MailBirdAU/MailBird/docs/Scope Captures/Begin(58) Write(36) End().jpg

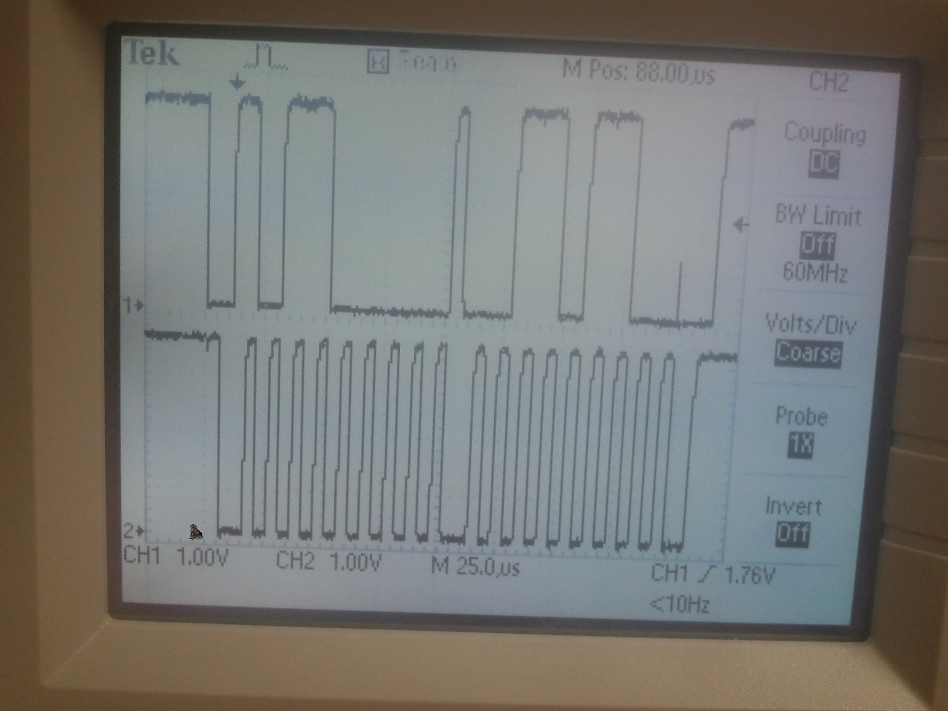
docs/Scope Captures/Begin(58) Write(36) End().jpg
