MailBirdAU/MailBird/README.md

MailBird
========

An Auburn University EE Senior Design Project
