MailBirdAU/MailBird/docs/Proposal/Proposal Presentation.pptx

Hugh Dillon, Zac Hawkins, Rick Holloway, Ben Smith, Hunter Thorington

MailBird

## OVERVIEW

- Mail Delivery Drone
- GPS – General Location
- Guidance Module – Precise Location
- Infrared LED Landing Pad

## Design Standards

- GPS Protocol
- RC Frequency – 2.4 GHz (Manual Flight Control)
- Flight Standards
  - Less than 4.4 pounds
  - Less than 400 feet above ground
  - Daylight conditions
  - 5 miles away from airports

## Constraints

- Economic Feasibility
  - Low cost quadcopter
  - Long battery life
- Manufacturability
  - Quadcopter
  - Guidance module

## Constraints

- Public Health and Safety
  - Max altitude
  - Avoid congested areas
- Privacy
  - No video camera

## Management Approach

- Decisions made by consensus in planning meetings
- Activities tracked on GitHub (https://github.com/MailBirdAU/MailBird)
- Communication via Github and GroupMe
- Meetings 2-3 hours per day, 4 days/week
- Minutes recorded by team leader

## Facilities

- Lab 368 – Design Lab
- Labs 308 and 310 – Computer Labs
- Outdoor Testing

## Budget

- Total budget of $50 per team member
- Estimated costs: ~$180
- Unexpected costs: ~$70

## timeline

- Proposal: January 22
- Cycle 1: March 6
  - Product prototype by end of February
- Cycle 2: April 25
  - Final design report by April 18
  - Senior Design Fair: April 25
