MailBirdAU/MailBird/docs/Proposal/Proposal.docx

Hugh Dillon | Zac Hawkins | Rick Holloway | Ben Smith | Hunter Thorington

# MAILBIRD

PROPOSAL FOR AN AUTONOMOUS DELIVERY SYSTEM

Wednesday | January 22, 2014

# 1 Project Description

## Abstract

This document details the preliminary approach to an autonomous package delivery system. A summary is given of the design specifications, and of the system that will be created to satisfy those conditions. Consideration is given to design decisions, technical specifics for implementation, and the anticipated use of the completed system. In addition, procedures are defined for project management, financial operations, and distribution of equipment after project completion.

## Executive summary

MailBird is a proof-of-concept automated mail system. A successful guidance system will use GPS to bring a quadcopter within five feet of the desired landing area. Subsequent to GPS localization, it will use a custom built guidance module to dock within a tolerance of 1 inch. The technical aspect of the project will be designing an aircraft guidance module and associated ground station (if necessary) to land in a precise location carrying a deliverable. This will be accomplished with a quadcopter equipped with an augmented precision external landing module (APELM), for extreme accuracy. The APELM will be designed to use infrared optics and LEDs to determine position. This module will interface with the flight controller to guide the docking procedure. After creating an effective, precision landing system, if time allows the system will be extended to include a software suite and mail delivery peripherals. The final result will be a comprehensive autonomous delivery system supported by a suite of a custom-designed scheduling, pick-up and delivery software.

## Project Definition

The MailBird project arose out of an Auburn University electrical engineering senior design section. After discussing numerous ideas, the design team decided that a satisfying project would involve a quadcopter. The intention was to use the unique flight capabilities of a quadcopter to accomplish a common task from both a literally and figuratively different perspective. Brainstorming with this constraint resulted in a large amount of ideas. One potential application placed a security camera in a difficult to reach area, such as the roof or exterior of a building. Another idea gave the quadcopter the ability to determine its surroundings and avoid obstacles while traversing from one location to another. Ultimately, elements of each idea were combined into a system that could carry an object and determine the location of a landing station in an environment. A parcel delivery system was the realization of the final idea; it would accomplish a common task from a different perspective, and it involved locating a delivery location for the parcel it would be carrying.

# 2 Technical Approach

## Design Considerations

We considered four options for transporting a package from one location to another via the quadcopter. The first option was solely using GPS to deliver the package to a predetermined location. However, the GPS location varies within a five foot radius. Since the required tolerance is within an inch of the desired landing area, GPS only will not suffice. The following three options all use GPS to bring the package within a five foot radius and use the custom guidance module to land.

The following three options were considered to precisely land the quadcopter: a camera to locate infrared LEDs on the ground, an optical camera to locate a red square on the ground, or an ultrasonic device to detect the frequency of the reception of sound waves. The following Pugh chart compares the three options.

Table 1 – Landing Implementation Comparison

The Pugh chart above is weighted to emphasize fulfilling the goals and enabling reproduction of Mailbird. All of the above options are complex in design and precise when it comes to landing so there is no differentiation in these two categories. Because of the affordability and reliability of the infrared camera and LEDs the net score is higher for option 1 (IR LED), which is the design chosen for mailbird.

Another design consideration that was analyzed by Pugh charts was whether to fly from dock to delivery location on a predetermined path or by going to the location with collision avoidance implemented on the quadcopter.

Table 2 – Guidance Implementation Comparison

The Pugh chart above is weighted according to the difficulty of the two choices and in order to not break any regulations already established by the FAA. Although collision avoidance in theory sounds good the practicality and difficulty of it compared to a predetermined route makes it a bad option.

The last Pugh Chart is shown to demonstrate why the design chosen is for general quadcopters and not just specific to the quadcopter used in MailBird. With a ratio of quadcopter size to landing pad size the design will hopefully be able to be implemented on any ArduCopter device.

Table 3 – Compatibility Comparison

## Potential Problems

The following is a list of potential problems we could run into with implementing the IR camera and predetermined path onto the MailBird:

### Coding limitations

Our group as a whole is not familiar yet with Arduino programming and how to respond to the infrared camera on the ArduCopter.

### Infrared White-out

How will the sun affect the IR camera? Will the sun reflect off the ground and cause the camera to see nothing but IR light? If this is the case, one alternative we have considered is building a focal point made out of PVC pipe painted black to block out some of the other light shining into the camera.

### Carrying Capacity

What is the maximum size package that the Arduino can carry? What is the ratio of increased package weight to battery life? How much power is the camera circuit going to take from the battery?

### New Buildings

When construction is going on the MailBird will continually have to be reprogrammed due to changes in geography and obstacles like cranes.

### Landing Module

How much is it going to cost each customer to buy/build the landing zone?

## Market Constraints

The MailBird system is intended to deliver small packages from a central hub to predetermined mail-drop locations. The idea is directed towards a market that requires frequent or scheduled delivery of packages with essentially immediate delivery. Market attributes including economic feasibility, manufacturability, public health and safety, social opinion, environmental impact, and political implications were taken into consideration when designing the MailBird system.

In order for the project to be marketable at all it must first and foremost be designed with the idea of profitability. With an low investment cost for the entire system and even less when equipping the tracking module to an already built Arduino based delivery system the MailBird is easily and cheaply integrated into any delivery role. However the true gain comes from savings in labor and fuel costs. The MailBird is completely electric requiring only to be charged after every fifteen minutes of flight time. LiPo batteries power the system mainly due to their power to weight ratio, but also because they hold long battery life up to 1000 charge cycles and a cheap replacement cost. With a designed ten minute flight radius and instantaneous delivery the MailBird is designed to increase the productivity and satisfaction of an entire campus.


The system is designed to be manufactured as two separate components that when combined make up the complete MailBird delivery system. The first component is the landing sensor and algorithm which are simply manufactured on a printed circuit board to be attached to a number of autonomous delivery vehicles. A schematic of the landing module is included in Figure 1. The second component, the quadcopter requires human interaction to manufacture and test. Combining the two components using I/O ports on the Arduino based flight controller completes the MailBird delivery system. The final step for user compatibility requires developing delivery routes to fit each campus setting.

Figure 1 – Landing Module Schematic

Considerations when designing delivery routes on heavily populated campuses include avoiding densely foot traffic areas as well as developing delivery schedules around times with high pedestrian activity. The most dangerous aspect of the system to human safety is the four propellers approaching speeds of 1090rpm which provide lift and maneuverability for the MailBird. Propeller guards have been added into the quadcopter design in an attempt to prevent any incident.

Even though any unwarranted malfunction that would cause the quadcopter to fall out of flight could possibly be dangerous to the public the design chosen develops a simple, clean, safe image in the public eye. This image along with custom designed flight paths avoiding areas of high traffic and at the maximum altitude allowed by law will keep the MailBird out of a weary public eye.

Using the maximum allowed altitude not only eases the mind of the public, but it also cuts down on the noise pollution to the environment. Designed to fly at an altitude upwards of 400ft the MailBird delivery system is barely audible. The system is also 100% electric only requiring 33W per charge.

However, it is not only the minds of the public that must be convinced of its safety and ethics, the design is also largely shaped by politics and government regulations. Recently with allegations of the government’s invasion of privacy and the fear of drones being folded into this spying scheme there is a fine line to what robots can be designed to do. The MailBird design does not contain a video camera that could be used for unwanted data acquisition. If not handled correctly it may be equipped with aftermarket components for unwanted militarization or espionage. The MailBird is designed to calculate accurate altitude information in order to abide by FFA airspace regulations and remain on a level legal for RC vehicles.

## Design Standards

GPS frequency/information protocol – GPS data transmitted over the L1 frequency band (1575.42 MHz), using NMEA 0183 data protocol.

Flight Height – H.R. 658 (FAA Air Transportation Modernization and Safety Improvement Act). SEC. 334 (b) Standards for Operation and Certification – Not later than December 31, 2015, the Administrator shall develop and implement operational and certification requirements for the operation of public unmanned aircraft systems in the national airspace system. This will most likely be close to SEC. 334 (c) Agreements with Government Agencies (2) The agreements shall – (C) allow government public safety agency to operate unmanned aircraft weighing 4.4 pounds or less, if operated – (ii) less than 400 feet above the ground; (iii) during daylight conditions; (v) outside of 5 statute miles from any airport.

RC Frequency – Manual flight control transmitted over 2.4GHz spread spectrum.

# 3 Management Approach

Lab meeting times are Monday from 2-5 PM, Tuesday from 3-6 PM, and Wednesday from 3-5 PM. The design process is divided into two, six-week long cycles. Each cycle is divided into week-long management iterations. Wednesday marks the beginning of each iteration, and the first part of Wednesday’s meeting will be to plan out what can be accomplished within the week. At the end of the iteration, on Tuesday, we will generate a summary from the minutes and GitHub task tracking to create a weekly status report. Decisions are made by majority consensus. At the beginning of each cycle, we will use the first meeting to plan out what needs to be done and then create associated tasks in our GitHub project. Each team member will be assigned tasks to complete by a given deadline. During each meeting, we will take the first 10 minutes to describe what we’re trying to accomplish, and our intended solutions. This will be a time for the team to collaborate and share ideas.

GitHub will be used as both the primary method of communication and activity tracking. Tasks will be created and heavily organized so that there is a clear measure of progress and completion percentage. Each task description will have criterion for task completion and the filepath for each associated file for the task. When work has been done on a task, a comment should be added stating progress and the description updated to show the status of the task. Once all completion points are accomplished, the task should be closed.

Minutes will be taken during the first 10 minutes of each meeting and then gleaned from the GitHub task comments. This will keep our team updating the GitHub regularly and descriptively.

# 4 Budget

The most expensive component of the project is the quadcopter. As one of the team members already owns a custom-built quadcopter, he lent it to the team for the project, which significantly reduces costs. The costs of the project were therefore divided into a few general areas: the guidance module (detects the LEDs on the landing pad in order to precisely land the quadcopter), the landing pad (the base on which the quadcopter lands, which simulates a mailbox), the drop mechanism (used to carry mail), replacement parts for the quadcopter (to replace components that may be damaged while testing the senior design project), and a couple categories for other costs (such as shipping or extra parts). The estimated costs for the above categories came to approximately 72% of the available funds for the project (available funds calculated assuming a $50 contribution by each team member), which left 28% of the available funds for unforeseen expenses. A detailed view of the project budget can be seen in Appendix I.

# 5 Timeline

The proposal is to be completed by January 22. A working prototype of the guidance module camera shall be used during the proposal to demonstrate that the camera can detect infrared lights and position them relative to each other, an integral component of the precision landing portion of the project. A complete working prototype of the mail drone will be complete by the end of February. The rest of Cycle 1 (which ends March 6) consists of preparing the report and presentation for the cycle. Cycle 2 shall consist of finalizing the project, writing the user manual, and preparing the presentation and display for the Senior Design Fair. A detailed view of the project timeline can be seen in Appendix II.

# 6 Facilities To Be Used

## Design Lab – Hardware construction

Development of MailBird’s hardware components will use lab facilities provided by Auburn University. Lab 368, a research lab provided by Dr. Roppel provides the necessary tools to manufacture and test the electrical circuits required to build the APELM. The lab provides design tools such as bread boards and soldering irons and expendables such as wire, resistors, capacitors etc. The lab will also serve as the primary location to store and assemble the quadcopter and APELM module. The MailBird team (Team 1) has recovered the first workbench on the left wall of 368.

## Labs 308 & 310

The computer labs provided by the Auburn University Electrical Engineering Department will be the primary location for software development, team meetings, document preparation, and presentation preparation. The labs provide fast computers with large monitors for group work and software development.

## Testing

During the initial design phases of MailBird, testing requiring flight by the quadcopter will take place outside. During development, the unpredictability of flight paths and the need for accurate GPS coordinates necessitate (for the safety of the craft and other people) that a wide open area be used. Later in the development process when the aircraft’s flight has become more stable and predictable the APELM system can be tested and refined inside Lab 368.

# 7 Disposition Agreement

A Disposition Agreement executed as of January 13, 2014 and effective as of the 1st day of May, 2014, by and between Auburn University and Hugh Dillon, Rick Holloway, Zac Hawkins, Ben Smith, Hunter Thorington was created to ensure the fair and proper transfer of all MailBird property at the end of the semester. This agreement can be found in Appendix I.

# Appendix I – Project Budget

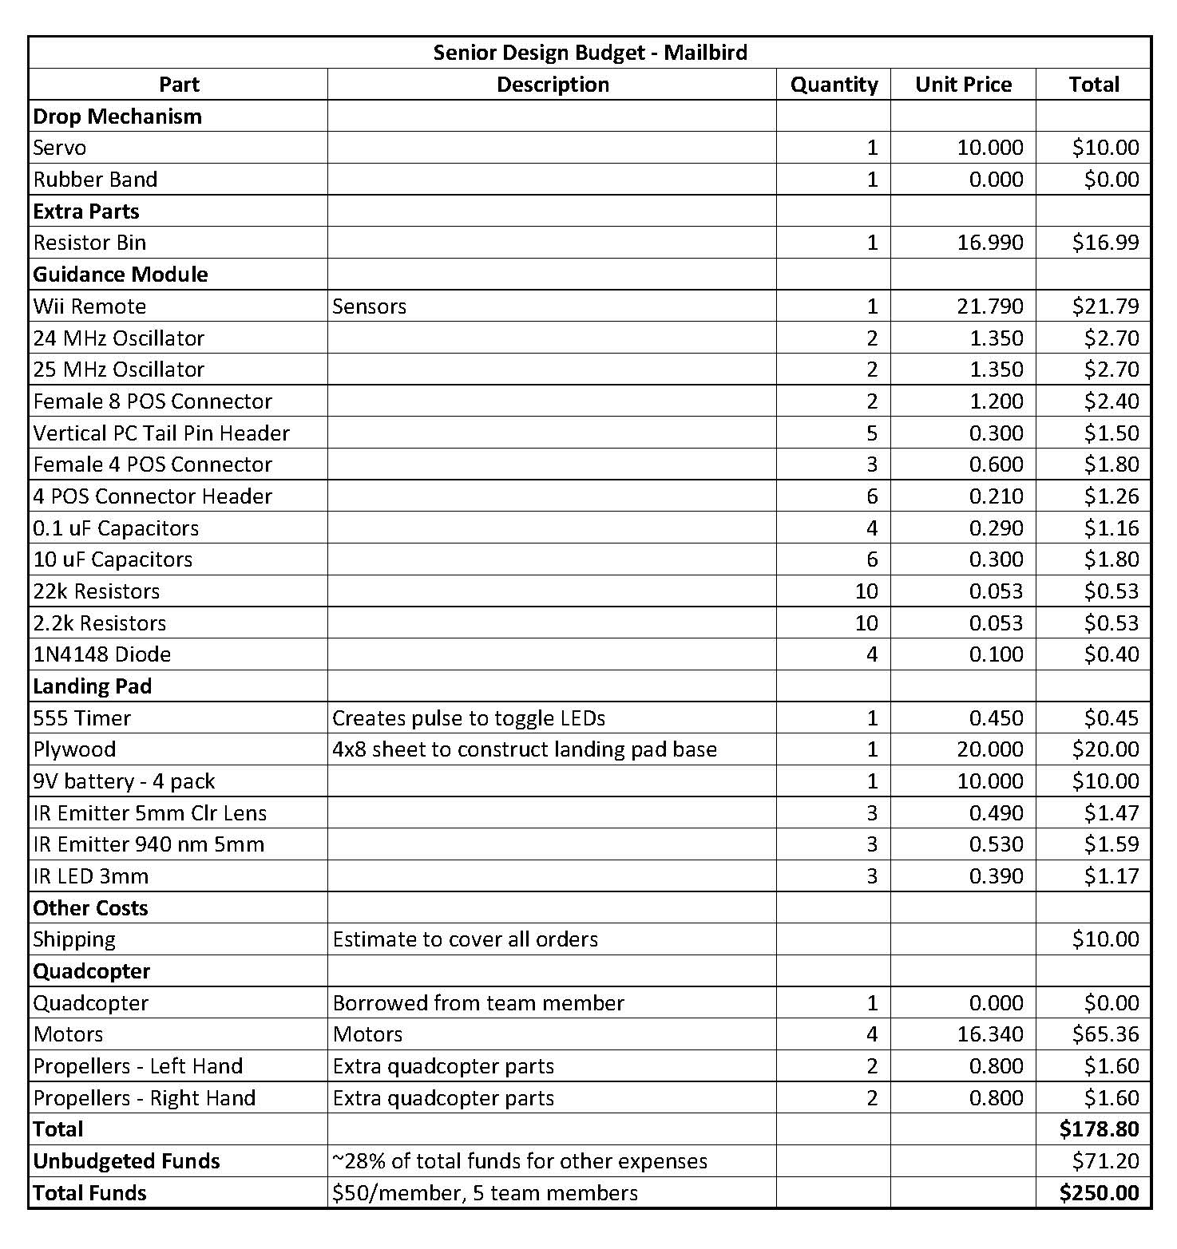
[picture p8: figure]

# Appendix II – Project Gantt Chart

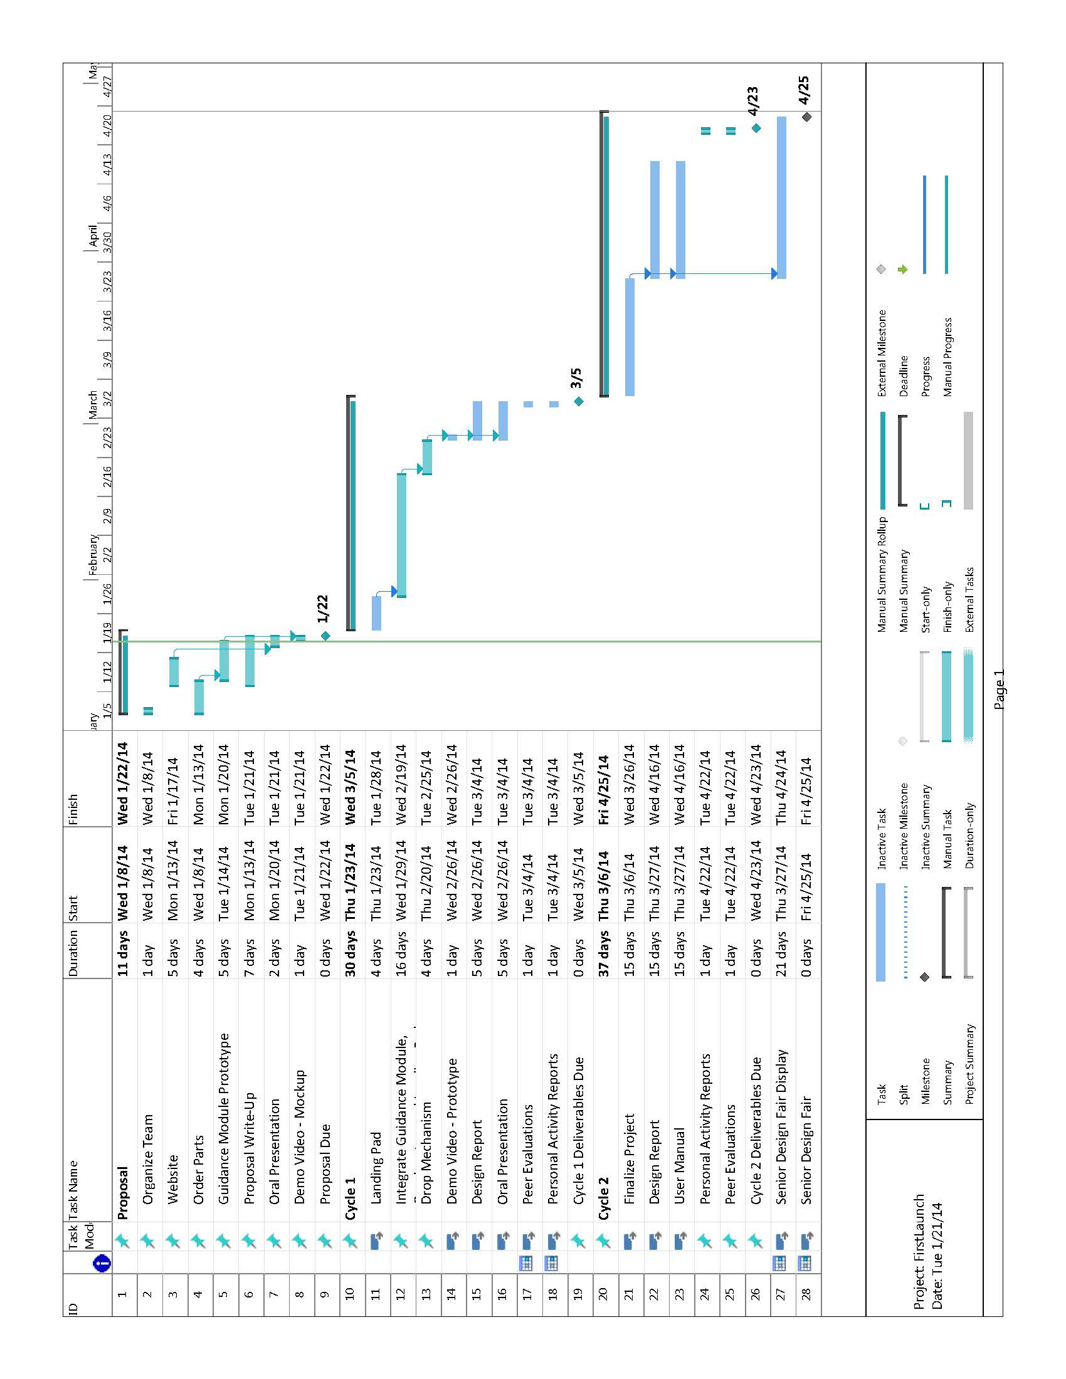
[picture p9: figure]

# Appendix III – Disposition Agreement

DISPOSITION AGREEMENT

This Disposition Agreement (this "Agreement"), executed as of January 13, 2014 and effective as of the 1st day of May, 2014, by and between Auburn University herein "Auburn” and Hugh Dillon, Rick Holloway, Zach Hawkins, Ben Smith, Hunter Thorington (herein "Team 1") In consideration of the mutual promises and covenants herein contained, the parties hereto agree as follows:

WHEREAS, Rick Holloway has agreed to lend full and unrestricted use and access to his personal custom model quad copter, herein “the Bird” to Team 1 for time period January 13, 2014 – May 1, 2014

WHEREAS, Auburn shall not retain any rights to the use of or access to Rick Holloway’s “the Bird”

WHEREAS, Team 1 shall accept as repayment for Rick Holloway’s generosity that all personal expenditures required for the development of “the Bird” shall be relinquished to Rick Holloway as personal property.

NOW THEREFORE, subject to the terms and conditions herein and acceptance by the Transferee Rick Holloway, and the Transferor Team 1 hereby agree to undertake the following actions as defined in Article I herein for the consideration stated herein.

ARTICLE I

TRANSFER OF THE BIRD

1.01

Immediately upon the execution of this Agreement the Transferor shall transfer the Bird to Rick Holloway.

1.02

The bird shall be free and clear of all liens and encumbrances and the Transferee shall have good title to the Bird immediately upon the execution of this Agreement.

By:

_________________________ ________________________

/s/ Thaddeus Roppel c/o Auburn /s/ Zac Hawkins

_________________________ _________________________

/s/Hugh Dillon /s/ Ben Smith

___________________________ ___________________________

/s/Rick Holloway /s/ Hunter Thorington
