MailBirdAU/MailBird/docs/Scope Captures/I2C-_write(0x58,1,0x36).jpg

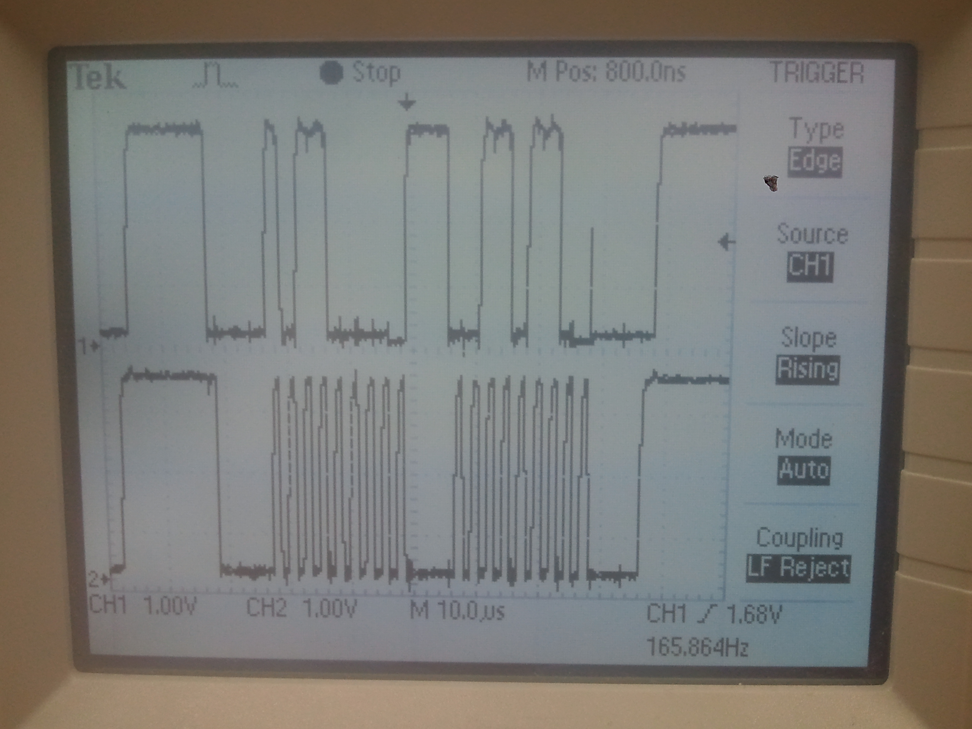
docs/Scope Captures/I2C-_write(0x58,1,0x36).jpg
