MailBirdAU/MailBird/docs/Status Reports/SRMar19/no lense.JPG

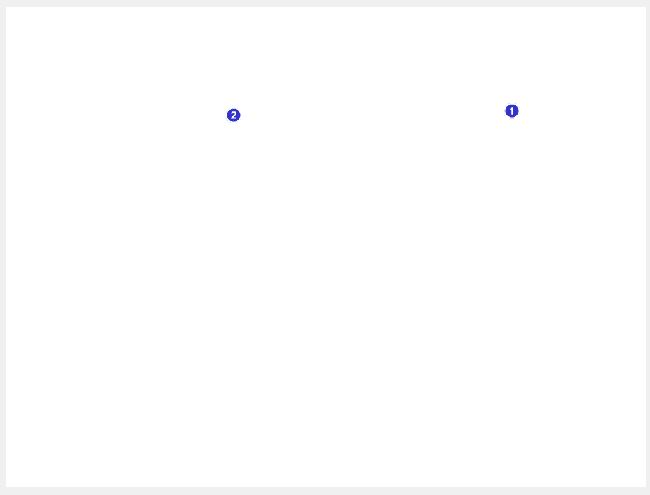
docs/Status Reports/SRMar19/no lense.JPG
