MailBirdAU/MailBird/docs/Status Reports/SRMar19/wide angle lense.JPG

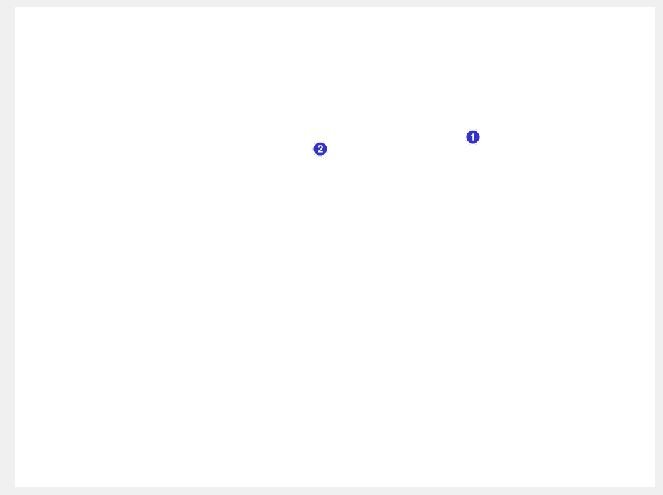
docs/Status Reports/SRMar19/wide angle lense.JPG
