MailBirdAU/MailBird/schematics/WiiSensorSchematic.jpg

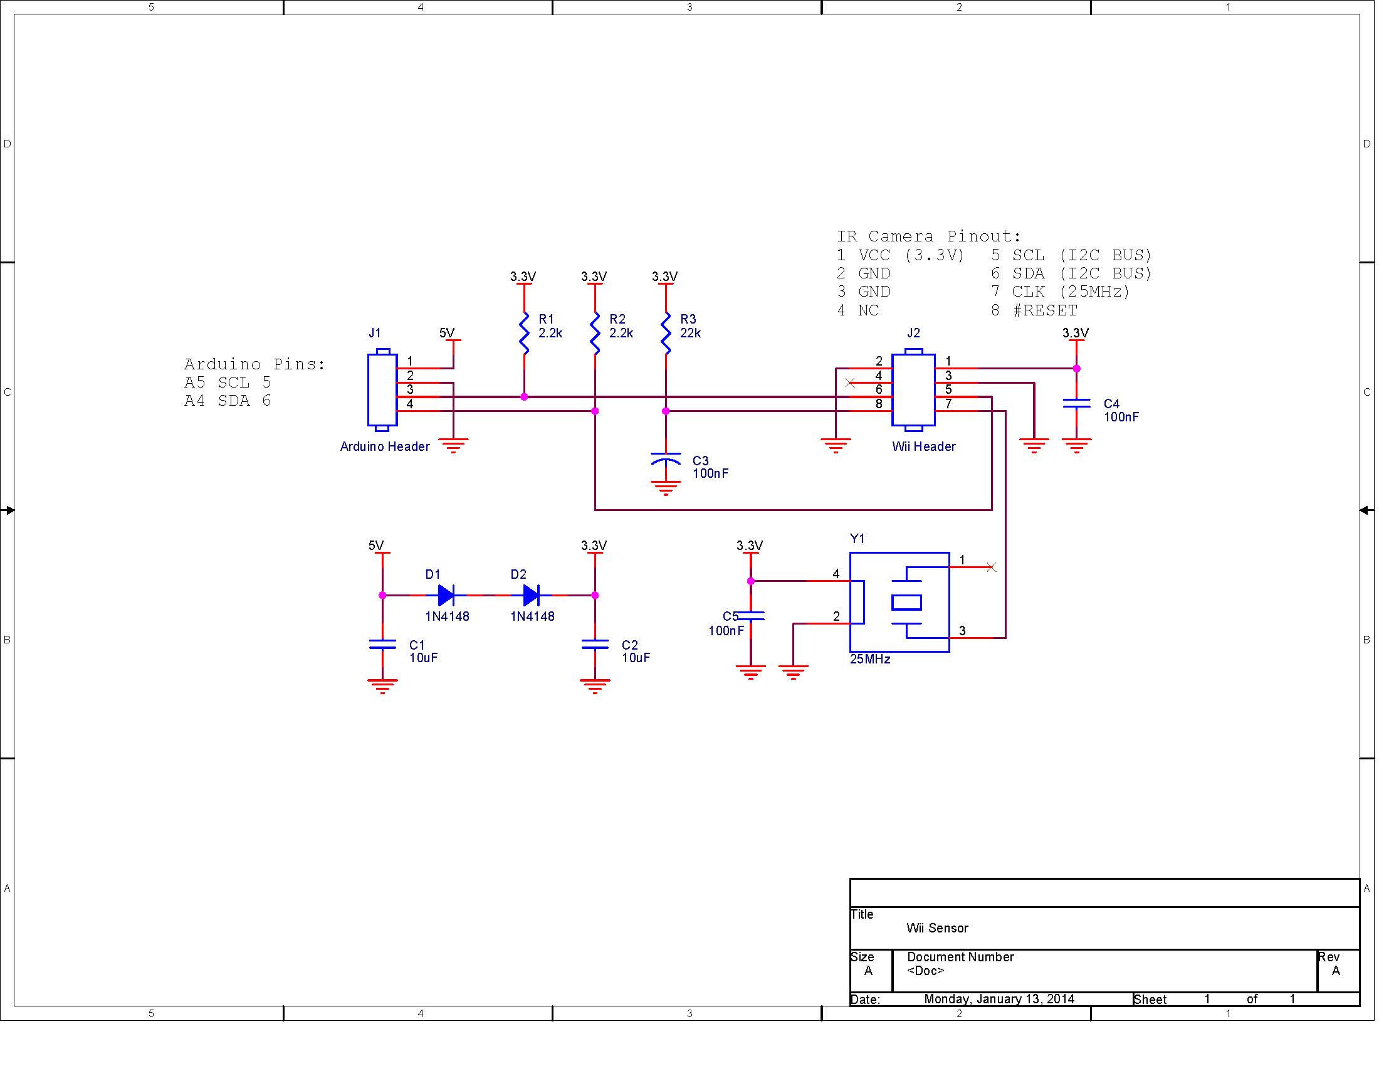
schematics/WiiSensorSchematic.jpg
