MailBirdAU/MailBird/video/Cycle 1 Demo Video/Cycle_1_Demo_Video_First_Frame.png

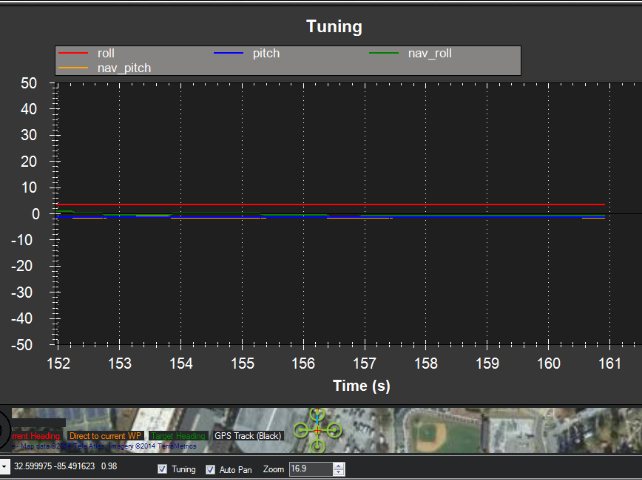
video/Cycle 1 Demo Video/Cycle_1_Demo_Video_First_Frame.png
