MailBirdAU/MailBird/web/Ben/robot.png

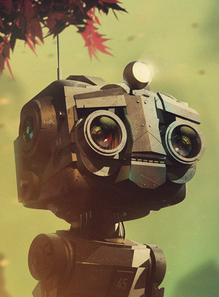
web/Ben/robot.png
