MailBirdAU/MailBird/web/Hugh/g10740.png

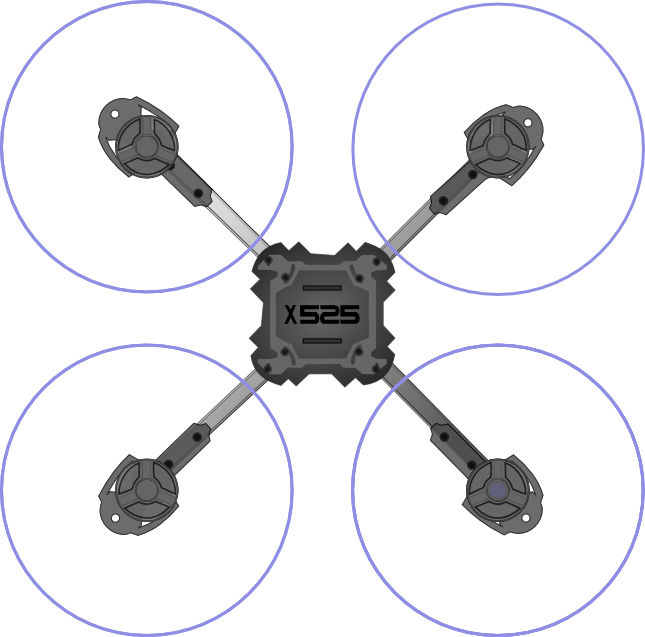
web/Hugh/g10740.png
