MailBirdAU/MailBird/web/Hugh/PropLeft.png

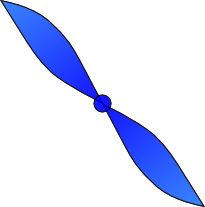
web/Hugh/PropLeft.png
