MailBirdAU/MailBird/docs/Proposal/Budget - Proposal.xlsx

Senior Design Budget - Mailbird
Part | Description |  | Quantity | Unit Price | Total
Drop Mechanism |  |  |  |  | $0.00
Servo |  |  | 1 | 10.000 | $10.00
Rubber Band |  |  | 1 | 0.000 | $0.00
Extra Parts |  |  |  |  | $0.00
Resistor Bin |  |  | 1 | 16.990 | $16.99
Guidance Module |  |  |  |  | $0.00
Wii Remote | Sensors |  | 1 | 21.790 | $21.79
24 MHz Oscillator |  |  | 2 | 1.350 | $2.70
25 MHz Oscillator |  |  | 2 | 1.350 | $2.70
Female 8 POS Connector |  |  | 2 | 1.200 | $2.40
Vertical PC Tail Pin Header |  |  | 5 | 0.300 | $1.50
Female 4 POS Connector |  |  | 3 | 0.600 | $1.80
4 POS Connector Header |  |  | 6 | 0.210 | $1.26
0.1 uF Capacitors |  |  | 4 | 0.290 | $1.16
10 uF Capacitors |  |  | 6 | 0.300 | $1.80
22k Resistors |  |  | 10 | 0.053 | $0.53
2.2k Resistors |  |  | 10 | 0.053 | $0.53
1N4148 Diode |  |  | 4 | 0.100 | $0.40
Landing Pad |  |  |  |  | $0.00
555 Timer | Creates pulse to toggle LEDs | http://www.digikey.com/product-detail/en/LM555CM/LM555CMFS-ND/1051271 | 1 | 0.450 | $0.45
Plywood | 4x8 sheet to construct landing pad base |  | 1 | 20.000 | $20.00
9V battery - 4 pack |  |  | 1 | 10.000 | $10.00
IR Emitter 5mm Clr Lens |  |  | 3 | 0.490 | $1.47
IR Emitter 940 nm 5mm |  |  | 3 | 0.530 | $1.59
IR LED 3mm |  |  | 3 | 0.390 | $1.17
Other Costs |  |  |  |  | $0.00
Shipping | Estimate to cover all orders |  |  |  | $10.00
Quadcopter |  |  |  |  | $0.00
Quadcopter | Borrowed from team member |  | 1 | 0.000 | $0.00
Motors | Motors |  | 4 | 16.340 | $65.36
Propellers - Left Hand | Extra quadcopter parts |  | 2 | 0.800 | $1.60
Propellers - Right Hand | Extra quadcopter parts |  | 2 | 0.800 | $1.60
Total |  |  |  |  | $178.80
Unbudgeted Funds | ~28% of total funds for other expenses |  |  |  | $71.20
Total Funds | $50/member, 5 team members |  |  |  | $250.00
