MailBirdAU/MailBird/(list of files, cad)

Other CAD files:
source/ArduCopter-3.1.0/Tools/autotest/aircraft/arducopter/Models/Untitled.skp
source/ArduCopter-3.1.0/Tools/autotest/aircraft/arducopter/Models/Y6_test.skp
source/ArduCopter-3.1.0/Tools/autotest/aircraft/arducopter/Models/Y6_test2.skp
source/ArduCopter-3.1.0/Tools/autotest/aircraft/arducopter/Models/_propeller0_.skp
source/ArduCopter-3.1.0/Tools/autotest/aircraft/arducopter/Models/plus_quad.skp
source/ArduCopter-3.1.0/Tools/autotest/aircraft/arducopter/Models/plus_quad2.skp
source/ArduCopter-3.1.0/Tools/autotest/aircraft/arducopter/Models/quad.skp
