MailBirdAU/MailBird/docs/Cycle 1/Gantt Chart - Cycle 1.pdf

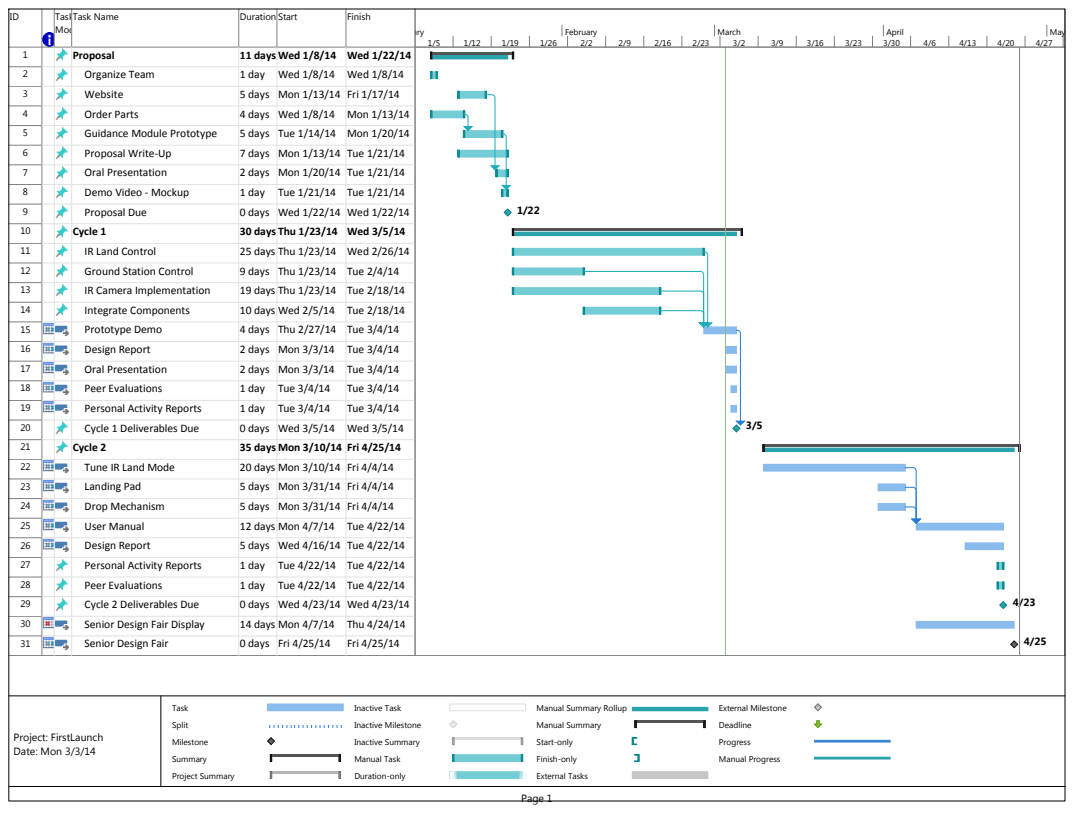
[picture p27: page 1]
Task; Mod; Task Name; Duration Start; Finish; Proposal; 11 days Wed 1/8/14; Wed 1/22/14; Organize Team; 1 day; Wed 1/8/14; Website; 5 days; Mon 1/13/14; Fri 1/17/14; Order Parts; 4 days; Guidance Module Prototype; Tue 1/14/14; Mon 1/20/14; Proposal Write‐Up; 7 days; Tue 1/21/14; Oral Presentation; 2 days; Demo Video ‐ Mockup; Proposal Due; 0 days; Cycle 1; 30 days Thu 1/23/14; Wed 3/5/14; IR Land Control; 25 days Thu 1/23/14; Wed 2/26/14; Ground Station Control; 9 days; Thu 1/23/14; Tue 2/4/14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

Manual Summary Rollup
Manual Summary
Start-only
Finish-only
External Tasks
