MailBirdAU/MailBird/schematics/IRLandMode Flowchart.pdf

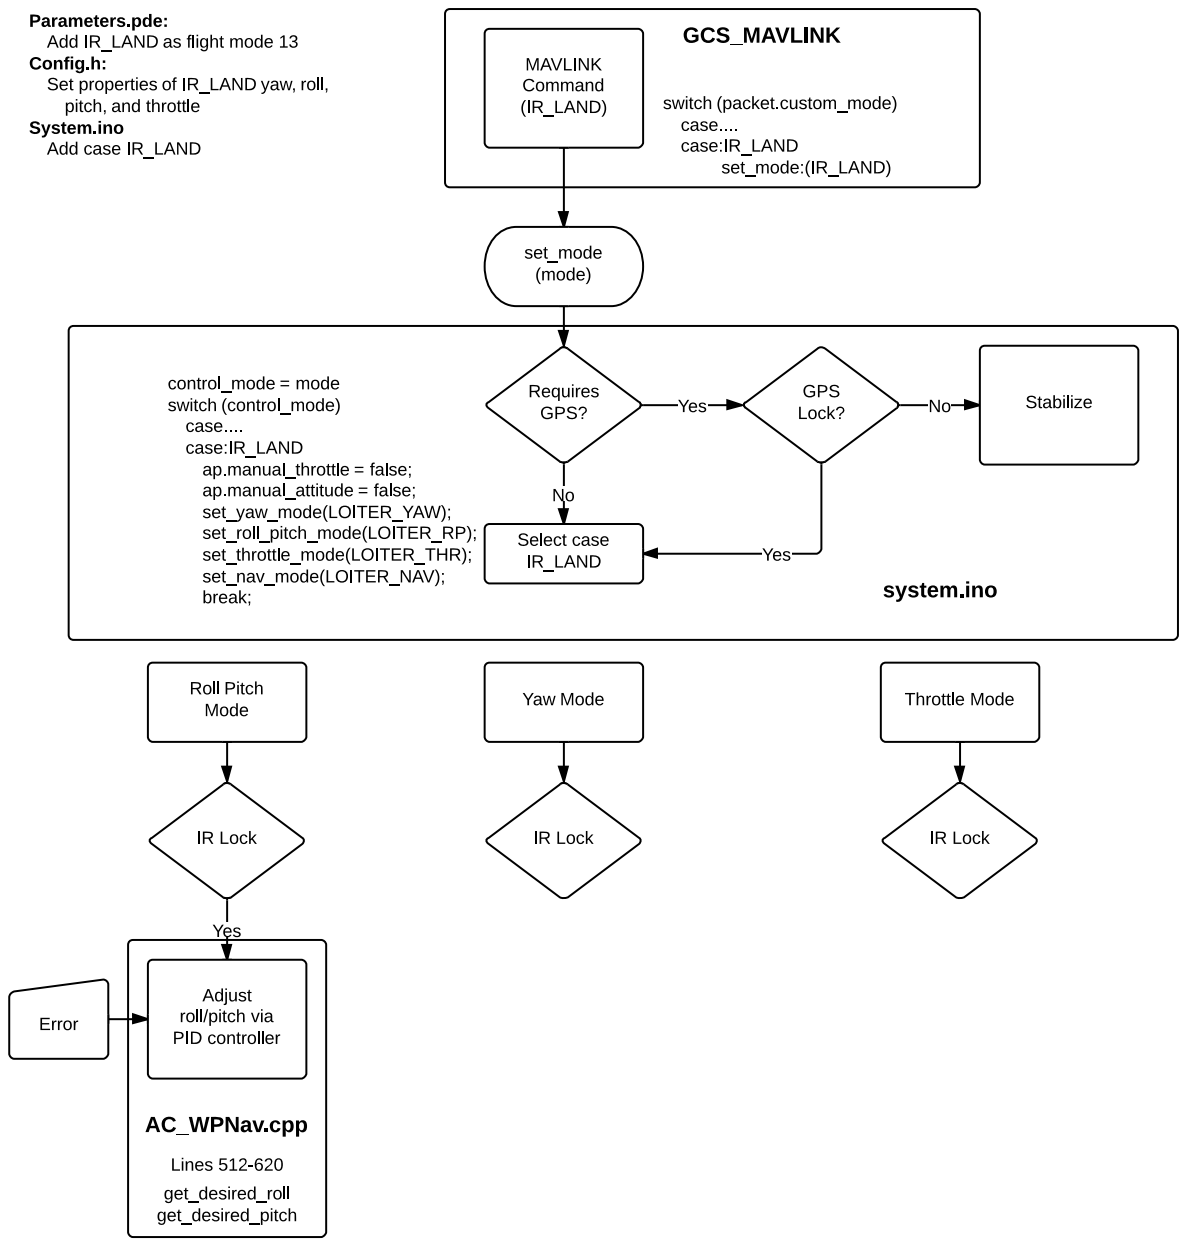
[picture p28: page 1]
