MailBirdAU/MailBird/web/Senior Design Gantt Chart.pdf

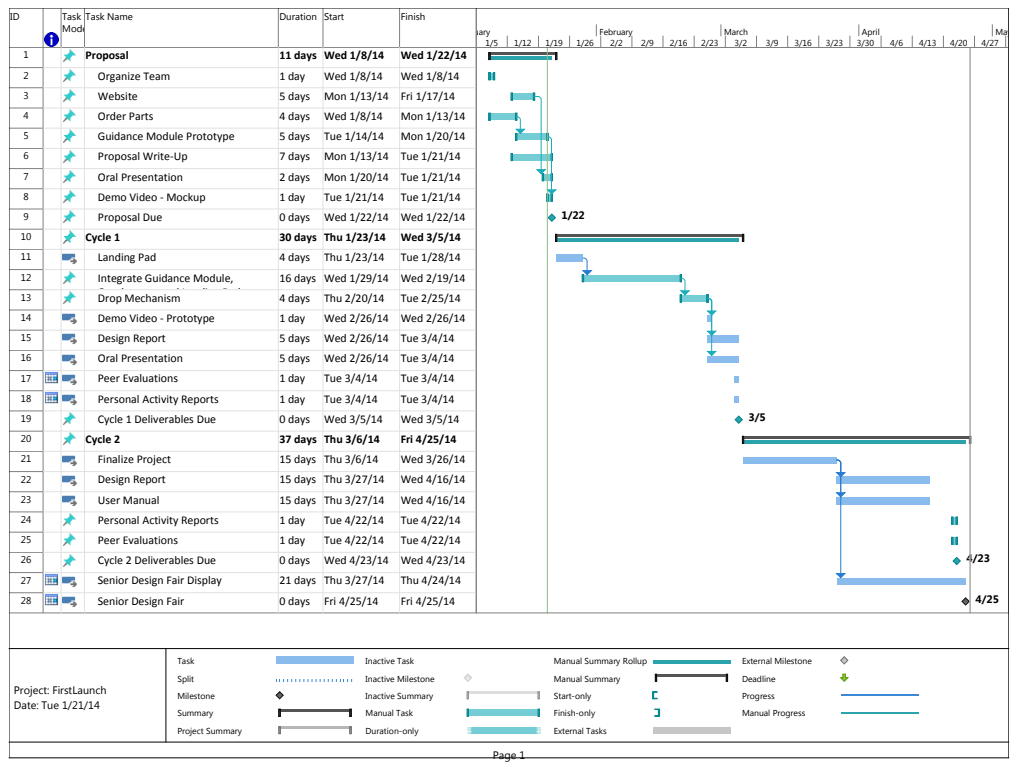
[picture p29: page 1]
uary; February; March; April; May; Task; Split; Milestone; Summary; Project Summary; Inactive Task; Inactive Milestone; Inactive Summary; Manual Task; Duration-only; External Milestone; Deadline; Progress; Manual Progress; Project: FirstLaunch Date: Tue 1/21/14

ID | Task Mode | Task Name | Duration | Start | Finish

1 | | Proposal | 11 days | Wed 1/8/14 | Wed 1/22/14 | 1/22
2 | | Organize Team | 1 day | Wed 1/8/14 | Wed 1/8/14
3 | | Website | 5 days | Mon 1/13/14 | Fri 1/17/14
4 | | Order Parts | 4 days | Wed 1/8/14 | Mon 1/13/14
5 | | Guidance Module Prototype | 5 days | Tue 1/14/14 | Mon 1/20/14
6 | | Proposal Write‐Up | 7 days | Mon 1/13/14 | Tue 1/21/14
7 | | Oral Presentation | 2 days | Mon 1/20/14 | Tue 1/21/14
8 | | Demo Video ‐ Mockup | 1 day | Tue 1/21/14 | Tue 1/21/14
9 | | Proposal Due | 0 days | Wed 1/22/14 | Wed 1/22/14
10 | | Cycle 1 | 30 days | Thu 1/23/14 | Wed 3/5/14
11 | | Landing Pad | 4 days | Thu 1/23/14 | Tue 1/28/14
12 | | Integrate Guidance Module, | 16 days | Wed 1/29/14 | Wed 2/19/14
13 | | Drop Mechanism | 4 days | Thu 2/20/14 | Tue 2/25/14
14 | | Demo Video ‐ Prototype | 1 day | Wed 2/26/14 | Wed 2/26/14
15 | | Design Report | 5 days | Wed 2/26/14 | Tue 3/4/14
16 | | Oral Presentation | 5 days | Wed 2/26/14 | Tue 3/4/14
17 | | Peer Evaluations | 1 day | Tue 3/4/14 | Tue 3/4/14
18 | | Personal Activity Reports | 1 day | Tue 3/4/14 | Tue 3/4/14
19 | | Cycle 1 Deliverables Due | 0 days | Wed 3/5/14 | Wed 3/5/14
20 | | Cycle 2 | 37 days | Thu 3/6/14 | Fri 4/25/14
21 | | Finalize Project | 15 days | Thu 3/6/14 | Wed 3/26/14
22 | | Design Report | 15 days | Thu 3/27/14 | Wed 4/16/14
23 | | User Manual | 15 days | Thu 3/27/14 | Wed 4/16/14
24 | | Personal Activity Reports | 1 day | Tue 4/22/14 | Tue 4/22/14
25 | | Peer Evaluations | 1 day | Tue 4/22/14 | Tue 4/22/14
26 | | Cycle 2 Deliverables Due | 0 days | Wed 4/23/14 | Wed 4/23/14
27 | | Senior Design Fair Display | 21 days | Thu 3/27/14 | Thu 4/24/14
28 | | Senior Design Fair | 0 days | Fri 4/25/14 | Fri 4/25/14

Manual Summary Rollup
Manual Summary
Start-only
Finish-only
External Tasks
