MailBirdAU/MailBird/source/ArduCopter-3.1.0/ArduCopter/config.h

#define __ARDUCOPTER_CONFIG_H__
#include "defines.h"
#ifdef USE_CMAKE_APM_CONFIG
 #include "APM_Config_cmake.h"  // <== Prefer cmake config if it exists
#else
 #include "APM_Config.h" // <== THIS INCLUDE, DO NOT EDIT IT. EVER.
#endif
#ifdef CONFIG_APM_HARDWARE
#error CONFIG_APM_HARDWARE option is deprecated! use CONFIG_HAL_BOARD instead
#endif
#ifndef CONFIG_HAL_BOARD
#error CONFIG_HAL_BOARD must be defined to build ArduCopter
#endif
#ifdef __AVR_ATmega1280__
#error ATmega1280 is not supported
#endif
#if CONFIG_HAL_BOARD == HAL_BOARD_APM2
 # define CONFIG_IMU_TYPE   CONFIG_IMU_MPU6000
 # define CONFIG_SONAR_SOURCE SONAR_SOURCE_ANALOG_PIN
 # define MAGNETOMETER ENABLED
 # ifdef APM2_BETA_HARDWARE
  #  define CONFIG_BARO     AP_BARO_BMP085
 # else // APM2 Production Hardware (default)
  #  define CONFIG_BARO          AP_BARO_MS5611
  #  define CONFIG_MS5611_SERIAL AP_BARO_MS5611_SPI
 # endif
#elif CONFIG_HAL_BOARD == HAL_BOARD_AVR_SITL
 # define CONFIG_IMU_TYPE   CONFIG_IMU_SITL
 # define CONFIG_SONAR_SOURCE SONAR_SOURCE_ANALOG_PIN
 # define MAGNETOMETER ENABLED
#elif CONFIG_HAL_BOARD == HAL_BOARD_PX4
 # define CONFIG_IMU_TYPE   CONFIG_IMU_PX4
 # define CONFIG_BARO       AP_BARO_PX4
 # define CONFIG_SONAR_SOURCE SONAR_SOURCE_ANALOG_PIN
 # define MAGNETOMETER ENABLED
#elif CONFIG_HAL_BOARD == HAL_BOARD_FLYMAPLE
 # define CONFIG_IMU_TYPE CONFIG_IMU_FLYMAPLE
 # define CONFIG_BARO AP_BARO_BMP085
 # define CONFIG_COMPASS  AP_COMPASS_HMC5843
 # define CONFIG_ADC        DISABLED
 # define MAGNETOMETER ENABLED
 # define CONFIG_SONAR_SOURCE SONAR_SOURCE_ANALOG_PIN
#elif CONFIG_HAL_BOARD == HAL_BOARD_LINUX
 # define CONFIG_IMU_TYPE CONFIG_IMU_L3G4200D
 # define CONFIG_BARO AP_BARO_BMP085
 # define CONFIG_COMPASS  AP_COMPASS_HMC5843
 # define CONFIG_ADC        DISABLED
 # define MAGNETOMETER ENABLED
 # define CONFIG_SONAR_SOURCE SONAR_SOURCE_ANALOG_PIN
#endif
 # define FRAME_CONFIG   QUAD_FRAME
 # define FRAME_ORIENTATION      X_FRAME
#if FRAME_CONFIG == HELI_FRAME
  # define RC_FAST_SPEED                125
  # define WP_YAW_BEHAVIOR_DEFAULT      WP_YAW_BEHAVIOR_LOOK_AHEAD
  # define RATE_INTEGRATOR_LEAK_RATE    0.02f
  # define RATE_ROLL_D                  0
  # define RATE_PITCH_D                 0
  # define HELI_PITCH_FF                0
  # define HELI_ROLL_FF                 0
  # define HELI_YAW_FF                  0
  # define STABILIZE_THR                THROTTLE_MANUAL_HELI
  # define MPU6K_FILTER                 10
  # define HELI_STAB_COLLECTIVE_MIN_DEFAULT   0
  # define HELI_STAB_COLLECTIVE_MAX_DEFAULT   1000
  # define THR_MIN_DEFAULT              0
    #define HELI_CC_COMP DISABLED
    #define HELI_PIRO_COMP DISABLED
#endif
#if FRAME_CONFIG == Y6_FRAME
  # define RATE_ROLL_P                  0.1f
  # define RATE_ROLL_D                  0.006f
  # define RATE_PITCH_P                 0.1f
  # define RATE_PITCH_D                 0.006f
  # define RATE_YAW_P                   0.150f
  # define RATE_YAW_I                   0.015f
#endif
#ifdef DESKTOP_BUILD
# define OPTFLOW DISABLED
#endif
#ifndef CONFIG_IMU_TYPE
 # define CONFIG_IMU_TYPE CONFIG_IMU_OILPAN
#endif
#ifndef MPU6K_FILTER
 # define MPU6K_FILTER MPU6K_DEFAULT_FILTER
#endif
#ifndef CONFIG_ADC
 # if CONFIG_IMU_TYPE == CONFIG_IMU_OILPAN
  #   define CONFIG_ADC ENABLED
 # else
  #   define CONFIG_ADC DISABLED
 # endif
#endif
#ifndef RC_FAST_SPEED
   #   define RC_FAST_SPEED 490
#endif
#if CONFIG_HAL_BOARD == HAL_BOARD_APM1
 # define LED_ON           HIGH
 # define LED_OFF          LOW
#elif CONFIG_HAL_BOARD == HAL_BOARD_APM2
 # define LED_ON           LOW
 # define LED_OFF          HIGH
#elif CONFIG_HAL_BOARD == HAL_BOARD_AVR_SITL
 # define LED_ON           LOW
 # define LED_OFF          HIGH
#elif CONFIG_HAL_BOARD == HAL_BOARD_PX4
 # define LED_ON           LOW
 # define LED_OFF          HIGH
#elif CONFIG_HAL_BOARD == HAL_BOARD_FLYMAPLE
 # define LED_ON           LOW
 # define LED_OFF          HIGH
#elif CONFIG_HAL_BOARD == HAL_BOARD_LINUX
 # define LED_ON           LOW
 # define LED_OFF          HIGH
#endif
 #define COPTER_LEDS ENABLED
#define COPTER_LED_ON           HIGH
#define COPTER_LED_OFF          LOW
#if CONFIG_HAL_BOARD == HAL_BOARD_APM2
 #define COPTER_LED_1 AN4       // Motor or Aux LED
 #define COPTER_LED_2 AN5       // Motor LED or Beeper
 #define COPTER_LED_3 AN6       // Motor or GPS LED
 #define COPTER_LED_4 AN7       // Motor LED
 #define COPTER_LED_5 AN8       // Motor LED
 #define COPTER_LED_6 AN9       // Motor LED
 #define COPTER_LED_7 AN10      // Motor LED
 #define COPTER_LED_8 AN11      // Motor LED
#elif CONFIG_HAL_BOARD == HAL_BOARD_APM1 || CONFIG_HAL_BOARD == HAL_BOARD_AVR_SITL || CONFIG_HAL_BOARD == HAL_BOARD_PX4
 #define COPTER_LED_1 AN8       // Motor or Aux LED
 #define COPTER_LED_2 AN9       // Motor LED
 #define COPTER_LED_3 AN10      // Motor or GPS LED
 #define COPTER_LED_4 AN11      // Motor LED
 #define COPTER_LED_5 AN12      // Motor LED
 #define COPTER_LED_6 AN13      // Motor LED
 #define COPTER_LED_7 AN14      // Motor LED
 #define COPTER_LED_8 AN15      // Motor LED
#else
 #undef COPTER_LEDS
#endif
#ifndef CONFIG_BARO
 # define CONFIG_BARO AP_BARO_BMP085
#endif
#ifndef CONFIG_SONAR_SOURCE
 # define CONFIG_SONAR_SOURCE SONAR_SOURCE_ADC
#endif
#if CONFIG_SONAR_SOURCE == SONAR_SOURCE_ADC && CONFIG_ADC == DISABLED
 # warning Cannot use ADC for CONFIG_SONAR_SOURCE, becaude CONFIG_ADC is DISABLED
 # warning Defaulting CONFIG_SONAR_SOURCE to ANALOG_PIN
 # undef CONFIG_SONAR_SOURCE
 # define CONFIG_SONAR_SOURCE SONAR_SOURCE_ANALOG_PIN
#endif
#if CONFIG_SONAR_SOURCE == SONAR_SOURCE_ADC
  #  define CONFIG_SONAR_SOURCE_ADC_CHANNEL 7
#elif CONFIG_SONAR_SOURCE == SONAR_SOURCE_ANALOG_PIN
  #  define CONFIG_SONAR_SOURCE_ANALOG_PIN 0
#else
 # warning Invalid value for CONFIG_SONAR_SOURCE, disabling sonar
 # define CONFIG_SONAR DISABLED
#endif
#ifndef CONFIG_SONAR
 # define CONFIG_SONAR ENABLED
#endif
 # define SONAR_ALT_HEALTH_MAX 3            // number of good reads that indicates a healthy sonar
 # define SONAR_RELIABLE_DISTANCE_PCT 0.60f // we trust the sonar out to 60% of it's maximum range
 # define SONAR_GAIN_DEFAULT 0.8            // gain for controlling how quickly sonar range adjusts target altitude (lower means slower reaction)
 # define THR_SURFACE_TRACKING_VELZ_MAX 150 // max vertical speed change while surface tracking with sonar
 # define CH7_OPTION            AUX_SWITCH_DO_NOTHING
 # define CH8_OPTION            AUX_SWITCH_DO_NOTHING
 #define HIL_MODE        HIL_MODE_DISABLED
#if HIL_MODE != HIL_MODE_DISABLED       // we are in HIL mode
 # undef GPS_PROTOCOL
 # define GPS_PROTOCOL GPS_PROTOCOL_NONE
 #undef CONFIG_SONAR
 #define CONFIG_SONAR DISABLED
#endif
#ifndef GPS_PROTOCOL
 # define GPS_PROTOCOL           GPS_PROTOCOL_AUTO
#endif
 # define MAV_SYSTEM_ID          1
 # define SERIAL0_BAUD                   115200
 # define SERIAL3_BAUD                    57600
 # define FS_BATT_VOLTAGE_DEFAULT       10.5f       // default battery voltage below which failsafe will be triggered
 # define FS_BATT_MAH_DEFAULT             0         // default battery capacity (in mah) below which failsafe will be triggered
 # define BOARD_VOLTAGE_MIN             4300        // min board voltage in milli volts for pre-arm checks
 # define BOARD_VOLTAGE_MAX             5800        // max board voltage in milli volts for pre-arm checks
 # define FAILSAFE_GPS_TIMEOUT_MS       5000    // gps failsafe triggers after 5 seconds with no GPS
 # define GPS_HDOP_GOOD_DEFAULT         200     // minimum hdop that represents a good position.  used during pre-arm checks if fence is enabled
 # define FS_GCS                        DISABLED
 # define FS_GCS_TIMEOUT_MS             5000    // gcs failsafe triggers after 5 seconds with no GCS heartbeat
#define FS_GCS_DISABLED                     0
#define FS_GCS_ENABLED_ALWAYS_RTL           1
#define FS_GCS_ENABLED_CONTINUE_MISSION     2
 # define PREARM_MAX_VELOCITY_CMS           50.0f   // vehicle must be travelling under 50cm/s before arming
#ifndef MAGNETOMETER
 # define MAGNETOMETER                   ENABLED
#endif
#if CONFIG_HAL_BOARD == HAL_BOARD_APM1 || CONFIG_HAL_BOARD == HAL_BOARD_APM2
  # define COMPASS_MAGFIELD_EXPECTED     330        // pre arm will fail if mag field > 544 or < 115
#else // PX4, SITL
 #ifndef COMPASS_MAGFIELD_EXPECTED
  #define COMPASS_MAGFIELD_EXPECTED      530        // pre arm will fail if mag field > 874 or < 185
 #endif
#endif
#ifndef CONFIG_ARCH_BOARD_PX4FMU_V1
  # define COMPASS_OFFSETS_MAX          600         // PX4 onboard compass has high offsets
#else   // APM1, APM2, SITL, FLYMAPLE, etc
 #ifndef COMPASS_OFFSETS_MAX
  # define COMPASS_OFFSETS_MAX          500
 #endif
#endif
#ifndef OPTFLOW                         // sets global enabled/disabled flag for optflow (as seen in CLI)
 # define OPTFLOW                       ENABLED
#endif
 # define OPTFLOW_ORIENTATION    AP_OPTICALFLOW_ADNS3080_PINS_FORWARD
 # define OPTFLOW_RESOLUTION     ADNS3080_RESOLUTION_1600
 # define OPTFLOW_FOV                    AP_OPTICALFLOW_ADNS3080_08_FOV
 #define OPTFLOW_ROLL_P 2.5f
 #define OPTFLOW_ROLL_I 0.5f
 #define OPTFLOW_ROLL_D 0.12f
 #define OPTFLOW_PITCH_P 2.5f
 #define OPTFLOW_PITCH_I 0.5f
 #define OPTFLOW_PITCH_D 0.12f
 #define OPTFLOW_IMAX 100
 # define AUTOTUNE  ENABLED
 # define SPRAYER  DISABLED
 # define FLIGHT_MODE_1                  STABILIZE
 # define FLIGHT_MODE_2                  STABILIZE
 # define FLIGHT_MODE_3                  STABILIZE
 # define FLIGHT_MODE_4                  STABILIZE
 # define FLIGHT_MODE_5                  STABILIZE
 # define FLIGHT_MODE_6                  STABILIZE
 # define FS_THR_VALUE_DEFAULT             975
 # define LAND_SPEED    50          // the descent speed for the final stage of landing in cm/s
 # define LAND_START_ALT 1000         // altitude in cm where land controller switches to slow rate of descent
 # define LAND_DETECTOR_TRIGGER 50    // number of 50hz iterations with near zero climb rate and low throttle that triggers landing complete.
 # define CAMERA        ENABLED
 # define MOUNT         ENABLED
 # define MOUNT2         DISABLED
#define EARTH_FRAME         0
#define BODY_FRAME          1
#define BODY_EARTH_FRAME    2
 # define STABILIZE_YAW           	YAW_HOLD
 # define STABILIZE_RP           	ROLL_PITCH_STABLE
#ifndef STABILIZE_THR
 # define STABILIZE_THR           	THROTTLE_MANUAL_TILT_COMPENSATED
#endif
 # define ACRO_YAW           	    YAW_HOLD
 # define ACRO_RP            	    ROLL_PITCH_IR_LAND
 # define ACRO_THR           	    THROTTLE_HOLD
 # define ACRO_LEVEL_MAX_ANGLE      3000
 # define SPORT_YAW           	    YAW_HOLD
 # define SPORT_RP            	    ROLL_PITCH_SPORT
 # define SPORT_THR           	    THROTTLE_HOLD
 # define ALT_HOLD_YAW           	YAW_HOLD
 # define ALT_HOLD_RP            	ROLL_PITCH_STABLE
 # define ALT_HOLD_THR           	THROTTLE_HOLD
#ifndef WP_YAW_BEHAVIOR_DEFAULT
 # define WP_YAW_BEHAVIOR_DEFAULT   WP_YAW_BEHAVIOR_LOOK_AT_NEXT_WP_EXCEPT_RTL
#endif
 # define AUTO_RP                   ROLL_PITCH_AUTO
 # define AUTO_THR                  THROTTLE_AUTO
 # define CIRCLE_YAW             	YAW_CIRCLE
 # define CIRCLE_RP                 ROLL_PITCH_AUTO
 # define CIRCLE_THR                THROTTLE_HOLD
 # define CIRCLE_NAV           	    NAV_CIRCLE
 # define CIRCLE_RADIUS             10              // radius in meters for circle mode
 # define CIRCLE_RATE               20.0f        // degrees per second turn rate
 # define GUIDED_RP                 ROLL_PITCH_AUTO
 # define GUIDED_THR                THROTTLE_AUTO
 # define GUIDED_NAV           	    NAV_WP
 # define LOITER_YAW             	YAW_HOLD
 # define LOITER_RP                 ROLL_PITCH_LOITER
 # define LOITER_THR                THROTTLE_HOLD
 # define LOITER_NAV                NAV_LOITER
 # define POSITION_YAW             	YAW_HOLD
 # define POSITION_RP               ROLL_PITCH_LOITER
 # define POSITION_THR              THROTTLE_MANUAL_TILT_COMPENSATED
 # define POSITION_NAV              NAV_LOITER
 # define RTL_RP                    ROLL_PITCH_AUTO
 # define RTL_THR                   THROTTLE_AUTO
 # define SUPER_SIMPLE           	DISABLED
 # define SUPER_SIMPLE_RADIUS    	1000
 # define RTL_ALT_FINAL             0       // the altitude the vehicle will move to as the final stage of Returning to Launch.  Set to zero to land.
 # define RTL_ALT 				    1500    // default alt to return to home in cm, 0 = Maintain current altitude
 # define RTL_ALT_MAX               8000    // Max height to return to home in cm (i.e 80m)
 # define RTL_LOITER_TIME           5000    // Time (in milliseconds) to loiter above home before begining final descent
 # define OF_LOITER_YAW          	YAW_HOLD
 # define OF_LOITER_RP              ROLL_PITCH_STABLE_OF
 # define OF_LOITER_THR             THROTTLE_HOLD
 # define OF_LOITER_NAV             NAV_NONE
 # define IR_RP                 ROLL_PITCH_IR_LAND
 # define ACRO_RP_P                 4.5f
 # define ACRO_YAW_P                4.5f
 # define STABILIZE_ROLL_P          4.5f
 # define STABILIZE_ROLL_I          0.0f
 # define STABILIZE_ROLL_IMAX    	0
 # define STABILIZE_PITCH_P         4.5f
 # define STABILIZE_PITCH_I         0.0f
 # define STABILIZE_PITCH_IMAX   	0
 # define STABILIZE_YAW_P           4.5f            // increase for more aggressive Yaw Hold, decrease if it's bouncy
 # define STABILIZE_YAW_I           0.0f
 # define STABILIZE_YAW_IMAX        0
 # define YAW_LOOK_AHEAD_MIN_SPEED  100             // minimum ground speed in cm/s required before copter is aimed at ground course
 # define ROLL_PITCH_INPUT_MAX      4500            // roll, pitch input range
 # define DEFAULT_ANGLE_MAX         4500            // ANGLE_MAX parameters default value
 # define ANGLE_RATE_MAX            18000           // default maximum rotation rate in roll/pitch axis requested by angle controller used in stabilize, loiter, rtl, auto flight modes
#ifndef RATE_ROLL_P
 # define RATE_ROLL_P        		0.150f
#endif
 # define RATE_ROLL_I        		0.100f
#ifndef RATE_ROLL_D
 # define RATE_ROLL_D        		0.004f
#endif
 # define RATE_ROLL_IMAX         	500
#ifndef RATE_PITCH_P
 # define RATE_PITCH_P       		0.150f
#endif
 # define RATE_PITCH_I       		0.100f
#ifndef RATE_PITCH_D
 # define RATE_PITCH_D       		0.004f
#endif
 # define RATE_PITCH_IMAX        	500
#ifndef RATE_YAW_P
 # define RATE_YAW_P              	0.200f
#endif
#ifndef RATE_YAW_I
 # define RATE_YAW_I              	0.020f
#endif
 # define RATE_YAW_D              	0.000f
 # define RATE_YAW_IMAX            	800
 #define MAX_ROLL_OVERSHOOT			3000
 #define MAX_PITCH_OVERSHOOT		3000
 #define MAX_YAW_OVERSHOOT			1000
 #define ACRO_BALANCE_ROLL			1.0f
 #define ACRO_BALANCE_PITCH			1.0f
 # define LOITER_P             		1.0f
 # define LOITER_I             		0.0f
 # define LOITER_IMAX          		0
 # define LOITER_RATE_P          	1.0f
 # define LOITER_RATE_I          	0.5f
 # define LOITER_RATE_D          	0.0f
 # define LOITER_RATE_IMAX       	400             // maximum acceleration from I term build-up in cm/s/s
 # define AUTO_YAW_SLEW_RATE    60              // degrees/sec
 # define THROTTLE_CRUISE       450             // default estimate of throttle required for vehicle to maintain a hover
 # define THR_MID_DEFAULT       500             // Throttle output (0 ~ 1000) when throttle stick is in mid position
#ifndef THR_MIN_DEFAULT
 # define THR_MIN_DEFAULT       130             // minimum throttle sent to the motors when armed and pilot throttle above zero
#endif
 # define THR_MAX_DEFAULT       1000            // maximum throttle sent to the motors
# define THROTTLE_IN_DEADBAND    100            // the throttle input channel's deadband in PWM
 # define ALT_HOLD_TAKEOFF_JUMP 20              // jump in altitude target when taking off in Loiter or AltHold flight modes
 # define ALT_HOLD_P            1.0f
 # define ALT_HOLD_I            0.0f
 # define ALT_HOLD_IMAX         300
 # define THROTTLE_RATE_P       6.0f
 # define THROTTLE_RATE_I       0.0f
 # define THROTTLE_RATE_D       0.0f
 # define THROTTLE_RATE_IMAX    300
 # define PILOT_VELZ_MAX    250     // maximum vertical velocity in cm/s
 # define ALT_HOLD_INIT_MAX_OVERSHOOT 200
 # define ALT_HOLD_ACCEL_MAX 250    // if you change this you must also update the duplicate declaration in AC_WPNav.h
 # define THROTTLE_ACCEL_P  0.75f
 # define THROTTLE_ACCEL_I  1.50f
 # define THROTTLE_ACCEL_D 0.0f
 # define THROTTLE_ACCEL_IMAX 500
 # define LOGGING_ENABLED                ENABLED
 # define LOG_ATTITUDE_FAST             DISABLED
 # define LOG_ATTITUDE_MED              ENABLED
 # define LOG_GPS                       ENABLED
 # define LOG_PM                        ENABLED
 # define LOG_CTUN                      ENABLED
 # define LOG_NTUN                      ENABLED
 # define LOG_IMU                       DISABLED
 # define LOG_CMD                       ENABLED
 # define LOG_CURRENT                   ENABLED
 # define LOG_MOTORS                    DISABLED
 # define LOG_OPTFLOW                   DISABLED
 # define LOG_PID                       DISABLED
 # define LOG_COMPASS                   DISABLED
 # define LOG_INAV                      DISABLED
 # define LOG_CAMERA                    ENABLED
#define LOGBIT(_s)     (LOG_ ## _s ? MASK_LOG_ ## _s : 0)
#define DEFAULT_LOG_BITMASK \
    LOGBIT(ATTITUDE_FAST)   | \
    LOGBIT(ATTITUDE_MED)    | \
    LOGBIT(GPS)             | \
    LOGBIT(PM)              | \
    LOGBIT(CTUN)            | \
    LOGBIT(NTUN)            | \
    LOGBIT(IMU)             | \
    LOGBIT(CMD)             | \
    LOGBIT(CURRENT)         | \
    LOGBIT(MOTORS)          | \
    LOGBIT(OPTFLOW)         | \
    LOGBIT(PID)             | \
    LOGBIT(COMPASS)         | \
    LOGBIT(INAV)
 #define AC_FENCE ENABLED
  #  define CLI_ENABLED           ENABLED
#ifndef GIT_VERSION
#define FIRMWARE_STRING THISFIRMWARE
#else
#define FIRMWARE_STRING THISFIRMWARE " (" GIT_VERSION ")"
#endif
