MailBirdAU/MailBird/source/ArduCopter-3.1.0/ArduCopter/APM_Config.h

// -*- tab-width: 4; Mode: C++; c-basic-offset: 4; indent-tabs-mode: nil -*-

// User specific config file.  Any items listed in config.h can be overridden here.

// If you used to define your CONFIG_APM_HARDWARE setting here, it is no longer
// valid! You should switch to using a HAL_BOARD flag in your local config.mk.

//#define FRAME_CONFIG QUAD_FRAME
/*
 *  options:
 *  QUAD_FRAME
 *  TRI_FRAME
 *  HEXA_FRAME
 *  Y6_FRAME
 *  OCTA_FRAME
 *  OCTA_QUAD_FRAME
 *  HELI_FRAME
 *  SINGLE_FRAME
 */

// uncomment the lines below to save on flash space if compiling for the APM using Arduino IDE.  Top items save the most flash space
//#define CLI_ENABLED           DISABLED            // disable the CLI (command-line-interface) to save 21K of flash space
//#define LOGGING_ENABLED       DISABLED            // disable dataflash logging to save 11K of flash space
//#define GPS_PROTOCOL          GPS_PROTOCOL_UBLOX  // hard code GPS to Ublox to save 8k of flash
//#define GPS_PROTOCOL          GPS_PROTOCOL_MTK19  // hard cdoe GPS to Mediatek to save 10k of flash
//#define MOUNT                 DISABLED            // disable the camera gimbal to save 8K of flash space
//#define AUTOTUNE              DISABLED            // disable the auto tune functionality to save 7k of flash
//#define OPTFLOW               DISABLED            // disable optical flow sensor to save 5K of flash space
//#define AC_FENCE              DISABLED            // disable fence to save 2k of flash
//#define CAMERA                DISABLED            // disable camera trigger to save 1k of flash
//#define COPTER_LEDS           DISABLED            // disable external navigation leds to save 1k of flash
//#define CONFIG_SONAR          DISABLED            // disable sonar to save 1k of flash

// features below are disabled by default
//#define SPRAYER               ENABLED             // enable the crop sprayer feature (two ESC controlled pumps the speed of which depends upon the vehicle's horizontal velocity)

// redefine size of throttle deadband in pwm (0 ~ 1000)
//#define THROTTLE_IN_DEADBAND   100

//#define HIL_MODE              HIL_MODE_SENSORS    // build for hardware-in-the-loop simulation

#define WII_CAMERA ENABLED
// User Hooks : For User Developed code that you wish to run
// Put your variable definitions into the UserVariables.h file (or another file name and then change the #define below).
#define USERHOOK_VARIABLES "UserVariables.h"
// Put your custom code into the UserCode.pde with function names matching those listed below and ensure the appropriate #define below is uncommented below
#define USERHOOK_INIT userhook_init();                      // for code to be run once at startup
//#define USERHOOK_FASTLOOP userhook_FastLoop();            // for code to be run at 100hz
//#define USERHOOK_50HZLOOP userhook_50Hz();                  // for code to be run at 50hz
//#define USERHOOK_MEDIUMLOOP userhook_MediumLoop();        // for code to be run at 10hz
#define USERHOOK_SLOWLOOP userhook_SlowLoop();            // for code to be run at 3.3hz
//#define USERHOOK_SUPERSLOWLOOP userhook_SuperSlowLoop();  // for code to be run at 1hz
