MailBirdAU/MailBird/(commit log)

2014-01-13 Initial draft of Proposal
    Very minimal population, but framework established.
2014-01-20 Budget and Gantt Chart
    [Budget - Proposal.xlsx]
2014-01-21 PowerPoint Presentation
2014-01-21 Gantt Chart PDF
    Printed the Gantt Chart to a pdf file
2014-01-28 Adding Minutes folder structure and moving all Proposal files into Proposal folder
    Will be adding minutes files to Git each meeting.
    [Budget - Proposal.xlsx]
2014-01-28 Arudcopter 3.0.1 Firmware
    Added flight mode 13, IR_LAND. IR_LAND currently is a copy of the LOITER
    flight mode. Files edited: Config.h Defines.h System.pde Parameters.pde.
    [Budget - Proposal.xlsx]
2014-01-28 Original Arducopter 3.0.1 Firmware
    Unaltered flight controller code.
    [Budget - Proposal.xlsx]
2014-01-29 Flowchart for IR Land Mode Code
    Describes the structure of the code for the IR Land Flight mode and
    contains relevant sections of code and filenames.
2014-01-30 IR Pitch/Roll Control Loop
    Copied Loiter mode control loop editing function names to fit IR mode
2014-01-31 IR Flag
    Because the GPS position control loop and the IR position control loop
    we are trying to implement are so similar we decided to add a flag to
    switch between GPS and IR error. This flag is set in
    set_roll_pitch_mode() in ArduCopter.ino and used in
    position_to_velocity() in AC_WPNav.cpp
    [ArduCopter.ino, Parameters.h, Parameters.ino, config.h, defines.h]
2014-02-03 Senior Design Timecards
    Added the excel spreadsheet that tracks our hours for the weekly status
    reports.
    [Senior Design Timecards.xlsx]
2014-02-03 camera_error x and y
    Created functions set_dist_error_x() and set_dist_error_y(). These
    functions are used to pass IR camera data into the loiter PI controller.
2014-02-03 2/3/14 - Rick
    [Senior Design Timecards.xlsx]
2014-02-03 Removed timecards
    Shifted our hours spreadsheet to Google Docs
    [Senior Design Timecards.xlsx]
2014-02-05 IRlock
    Created IRlock function to see leds before switching to IR_LAND
2014-02-05 Adding APM 2.6 Schematic files
    [APM_v2.brd, APM_v2.sch]
2014-02-06 Adding Wii Camera Libary and some user code
    aaWiiCamera is the library for the camera (its called aaWii... so that
    is show up at the top of the list no other reason). there are notes in
    aaWiiCamera.cpp that denote what work needs to be done to get the i2c
    running. This was all compiling on my machine at time of upload.
2014-02-13 Created Scope Captures Folder
    Scope Captures for dealing with I2C debug. Also Created captures one
    using the Wire.h to write 0x58 then 0x36 the next using APM I2Cdriver to
    do the same.
2014-02-18 I2C Working
    IRCam_init created in order to get the camera functioning.
2014-02-20 Creating Arducopter-3.1.0. Contains IR_LAND flight mode and working IR Camera I2C interface. This is the base version for compiling using the Arduino IDE
    [Advanced.param, ArduCopter.parm, ArduPlane.parm, Beginner.param, CameraPlatform.param, ConfiguringApps.txt, CopterAVC.parm, Intermediate.param]
2014-02-20 Updating HTML Experiment folder with spinning propellers
    Wanted to see if spinning propellers is an option on hover. It
    definitely is.
2014-02-24 Semi-working Roll_Pitch_IR_Land. Currently overwrites Alt Holds Roll/Pitch mode.
2014-02-26 Creating Status Report 5 - Feb 26
    Also including the electronic version of the original change list; I
    think it’s missing one or two changes but it’s a reference for what
    files to look through.
2014-03-04 Created Docs folder for Cycle 1
    Updated Budget for Cycle 1
    [Budget - Cycle 1.xlsx]
2014-03-04 Updated budget
    Added cost of JST 4-pin connectors. Compass to flight controller.
    [Budget - Cycle 1.xlsx]
2014-03-04 Removed I component of loiter PID loop. This makes for Cycle 1 demo able code.
2014-03-04 Updated flight mode, I2C, budget, and timeline. Hugh and Hunter still need to update MAVlink and Triangulation algorithm.
2014-03-05 Budget Change
    already shown in report. don't need to re import into cycle 1 report
    [Budget - Cycle 1.xlsx]
2014-03-05 Hunter's additions to the PPT
    added 3 slides. 2 for triang alg. 1 for wii circuit board
2014-03-05 Created Cycle1 Camera demo
2014-03-18 Lense Viewing angle pictures
2014-04-02 Removed userhook_SlowLoop (aka update_loiter). Also some other changes to LED port pins, etc.
2014-04-22 Cycle 2 Budget
    [Budget - Cycle 2.xlsx]
2014-04-22 Cycle 2 Budget Update
    [Budget - Cycle 2.xlsx]
2014-04-22 Cycle 2 Report - Updated Budget and Timeline
    [Budget - Cycle 2.xlsx]
